mefory/j280-rotary-pendulum/docs/images/hardware-bench.jpg

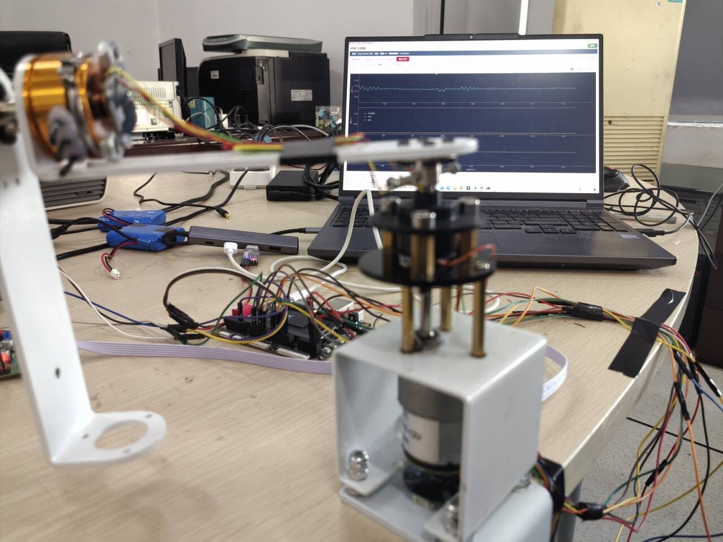
docs/images/hardware-bench.jpg
