mefory/j280-rotary-pendulum/docs/images/hardware-joint1.jpg

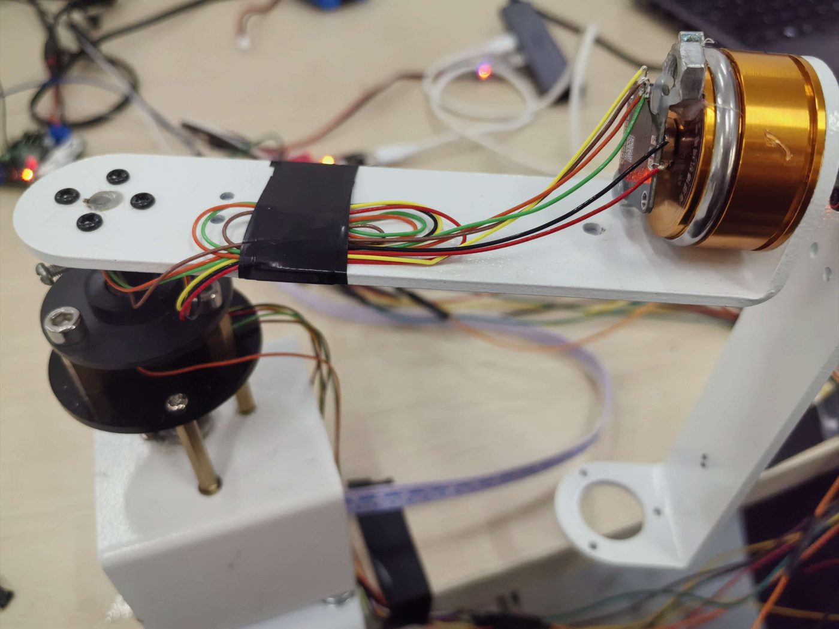
docs/images/hardware-joint1.jpg
