mefory/j280-rotary-pendulum/docs/images/hardware-motor2.jpg

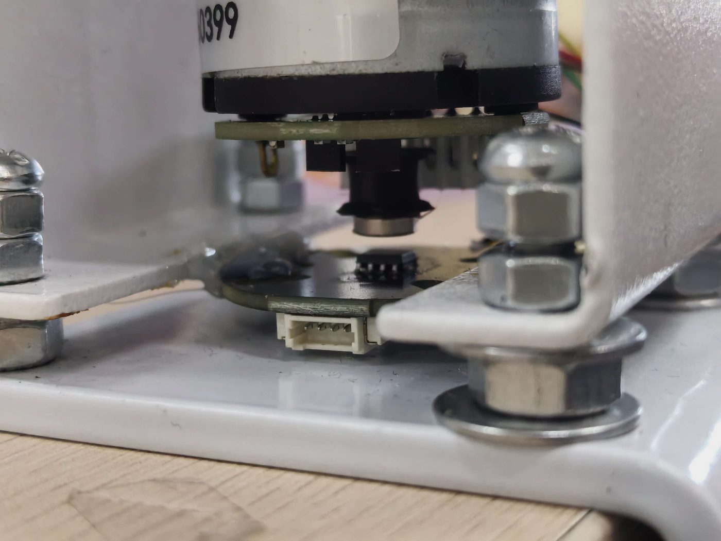
docs/images/hardware-motor2.jpg
