mefory/j280-rotary-pendulum/docs/images/hardware-motor3.jpg

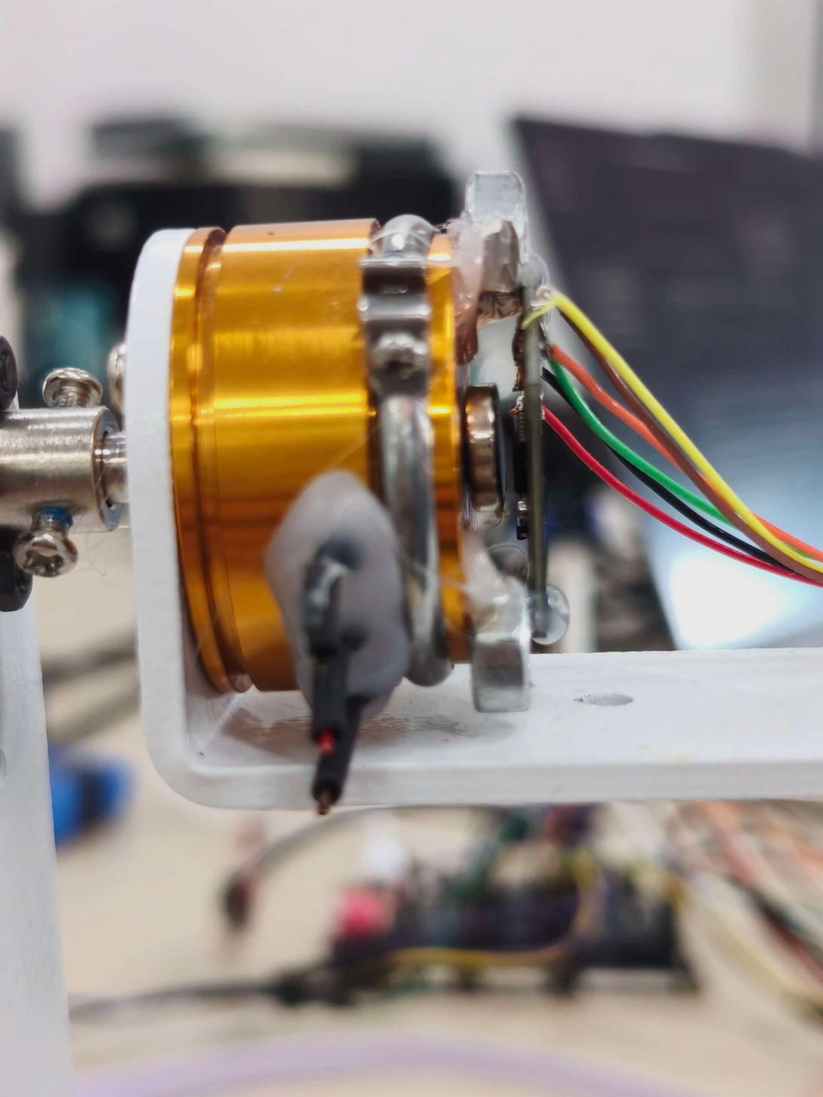
docs/images/hardware-motor3.jpg
