mefory/j280-rotary-pendulum/docs/images/hardware-motor.jpg

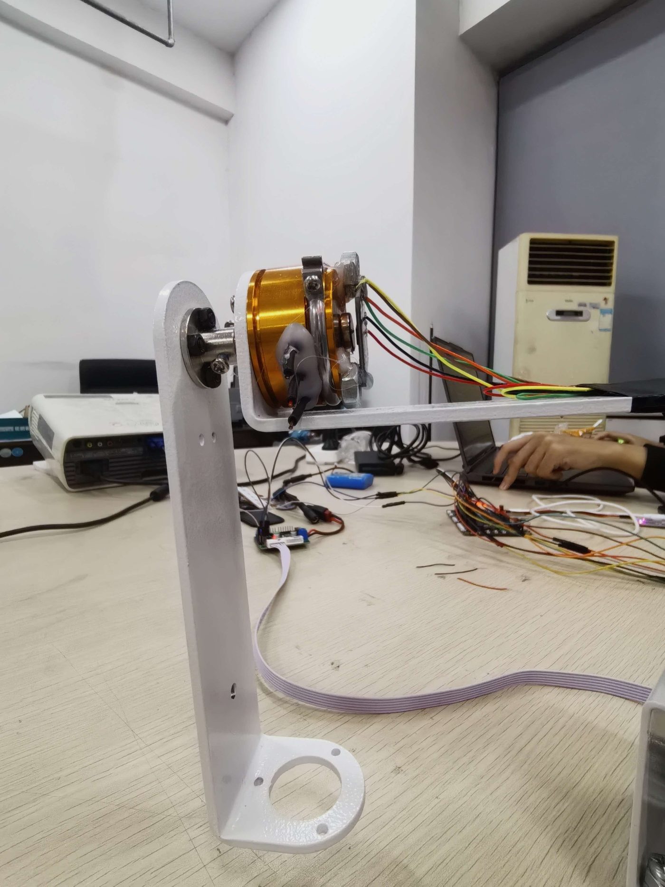
docs/images/hardware-motor.jpg
