mefory/j280-rotary-pendulum/(commit log)

2026-11-04 旋转倒立摆实时姿态控制系统：RTL + 上位机 + 全链路文档
    基于高云 GW2A (Tang Primer 20K) 的旋转倒立摆全栈开源实现：
    1 kHz 全定点硬件闭环、自动起摆、LQR 稳摆、0~360° 绝对定位、
    静摩擦锁零扭矩保持、500 Hz 遥测与在线参数整定。
    架构：
    - rtl/ctrl_core.v 与板级完全解耦，三套板壳（t20k/de10/j280）证明可移植性
    - 全链路定点（0.01° / 0.1°/s / 0.01% duty），增益 Q3.13，无浮点无除法器
    - 模型驱动：MATLAB 推导 LQR/观测器 → 生成 Verilog 头文件
    - 四段增益调度（稳摆/捕获/定位/移动），1024 ms 凸组合渐变
    实测指标（满电、trim 归零后）：
    -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
2026-11-04 README 重写为现代开源风格：徽章 + Mermaid 架构图 + 折叠技术亮点 + 工程真相表
    参考 LiteX/TinyTapeout/VexRiscv 等成熟硬件项目的呈现方式：
    - 居中标题 + 6 枚状态徽章（License/Platform/Language/loop/Fmax/Sim）
    - 一句话定位 + ASCII 机械示意（强调欠驱动本质）
    - 三能力卡片（起摆/稳摆/定位）
    - 分场景快速开始（无硬件仿真 / 有硬件构建），带标定硬性前提警告
    - Mermaid flowchart 架构图（传感→控制核→执行），含三处设计取舍表
    - 实测性能表（9 项，全部标注为实板遥测而非估算）
    - 4 个折叠技术亮点（静摩擦锁/坏区阻尼器/绝对目标/调试链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
2026-11-04 修复 Mermaid 架构图渲染：移除标签内的箭头符号与中点字符
    问题：节点标签 'IDLE→SWING→BAL⇄POS→SAFE' 中的 → 和 ⇄ 被 Mermaid 解析器
    当作连线语法，导致整张图渲染失败（只显示代码块）。
    修复：
    - 状态流转改为纯空格分隔（IDLE SWING BAL POS SAFE）
    - 移除标签内所有 · 中点（部分渲染器视为语法）
    - subgraph 标题去掉引号包裹（subgraph SENS[传感层] 更稳妥）
    - 移除 subgraph 内 direction TB（与 flowchart TB 冗余）
    - 链式箭头 A --> B --> C 拆成独立行（避免解析歧义）
2026-11-04 README/docs 嵌入实板照片与波形截图（13 张，从设计文档提取）
    从设计文档 15 张内嵌图中提取并按内容重命名（2 张重复，实为 13 张独立图）：
    - hardware-rig/motor/motor2/motor3/bench/joint1：机械本体、电机、台架、关节安装
    - hardware-t20k / hardware-tb6612：控制板与驱动板
    - gui-overview / gui-balance-curves / gui-pos-curves / gui-speed-curves：上位机
    总览页 + 三类实板波形（稳摆 α/θ/duty、位置目标切换、定速旋转速度跟踪）
    - fig-state-machine：IDLE/SWING/BALANCE/POS/SAFE 状态转移图
    README 新增两处视觉证据：
    - 「这是什么」段落后插机械本体照片 + 上位机总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
2026-11-04 README/docs 嵌入实板照片与波形截图（13 张，从设计文档提取）
    从设计文档提取 15 张内嵌图（2 张重复），按内容重命名：
    - hardware-*：机械本体、电机、台架、关节安装、T20K 控制板、TB6612 驱动板
    - gui-*：上位机总览页 + 三类实板波形（稳摆/位置切换/定速旋转）
    - fig-state-machine：五状态转移图
    README 新增：「这是什么」段后插本体照 + 上位机总览截图；「实测性能」表后
    新增 2×2 实板波形图组（稳摆/位置/定速旋转/控制板），每张附一句指标说明。
    docs 插入：architecture 状态机图、control-design 稳摆波形、hardware 本体+驱动板。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
2026-11-04 img: docs/images/hardware-joint1.jpg
2026-11-04 img: docs/images/hardware-motor.jpg
2026-11-04 img: docs/images/hardware-motor2.jpg
2026-11-04 img: docs/images/hardware-motor3.jpg
2026-11-04 首图换为装置全景照 + 新增 124 秒演示视频
    - hardware-setup.jpg：桌面级实验装置全景（648x487，83 KB，原 PNG 615 KB 压缩）
    比原局部特写更适合做首图，可见完整摆臂/关节伺服/底部驱动电机/调试工作台
    - demo.mp4：124 秒完整演示（568x320 30fps，12.9 MB → 4.2 MB，CRF 27）
    内容时序：2s 摆杆悬垂 → 20s 自动起摆成功 → 60s 稳摆 → 118s 稳摆+上位机波形屏
    - README 首屏改为全景照 + 视频入口，引用路径校验有效
