mefory/j280-rotary-pendulum/(notices)

Notices in the files:
README.md:
License: MIT
